nas256/ece3400-team13code/pcb/shield.brd

## EAGLE design pcb/shield.brd (2017-11-17)

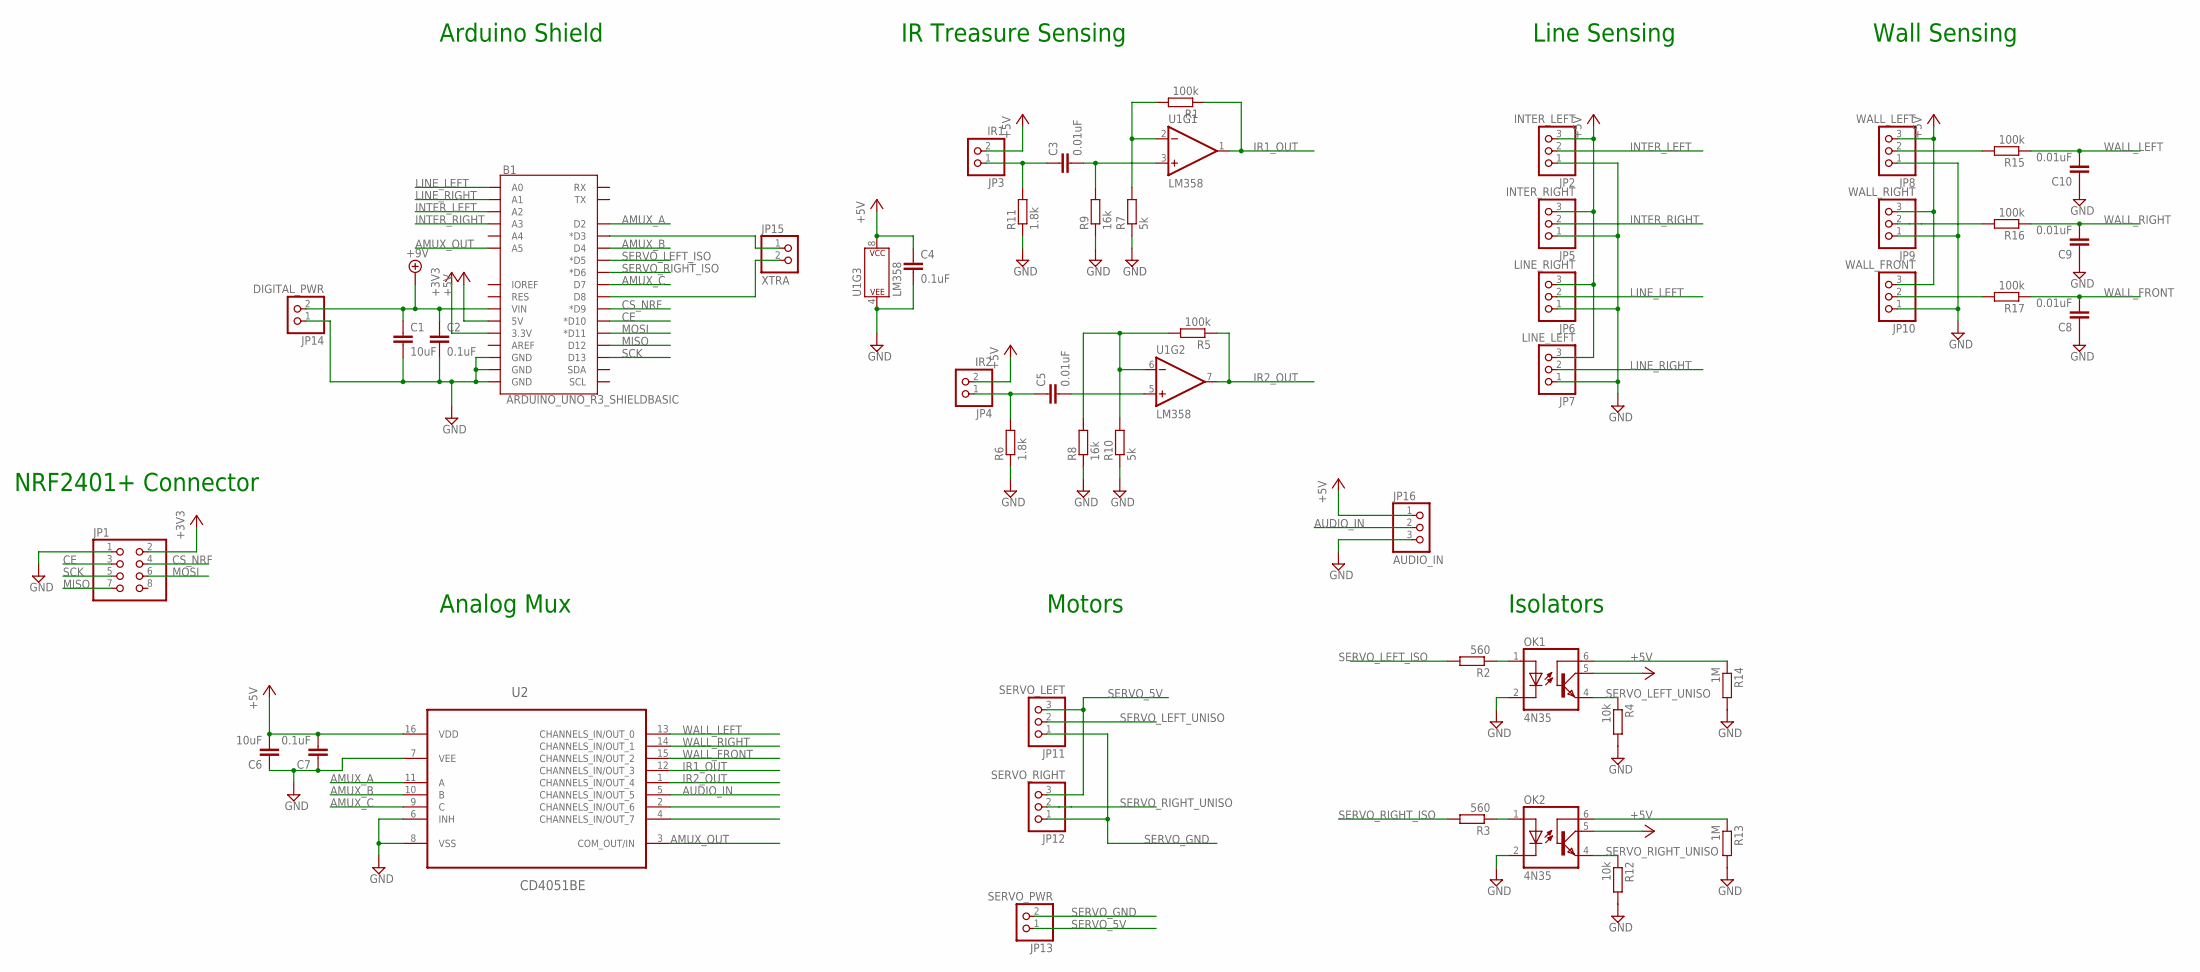
[picture p1: schematic shield.sch]

Parts:
B1: ARDUINO_UNO_R3_SHIELDBASIC; UNO_R3_SHIELD
C1, C6: 10uF; C5B3
C2, C7: 0.1uF; C5B3
C3, C5, C8, C9, C10: 0.01uF; C5B3
C4: 0.1uF; C2.5-2
JP1: PINHD-2X4; 2X04
JP2: INTER_LEFT; 1X03
JP3: IR1; 1X02
JP4: IR2; 1X02
JP5: INTER_RIGHT; 1X03
JP6: LINE_RIGHT; 1X03
JP7: LINE_LEFT; 1X03
JP8: WALL_LEFT; 1X03
JP9: WALL_RIGHT; 1X03
JP10: WALL_FRONT; 1X03
JP11: SERVO_LEFT; 1X03
JP12: SERVO_RIGHT; 1X03
JP13: SERVO_PWR; 1X02
JP14: DIGITAL_PWR; 1X02
JP15: XTRA; 1X02
JP16: AUDIO_IN; 1X03
OK1, OK2: 4N35; DIL06
R1, R5, R15, R16, R17: 100k; VMTA55
R2, R3: 560; VMTA55
R4, R12: 10k; VMTA55
R6, R11: 1.8k; VMTA55
R7, R10: 5k; VMTA55
R8, R9: 16k; VMTA55
R13, R14: 1M; VMTA55
U1: LM358; DIP08
U2: CD4051BE; DIP254P762X508-16

Connections:
+3V3: B1.3.3V, JP1.2
+5V: B1.5V, C4.1, C6.2, C7.2, JP2.3, JP3.2, JP4.2, JP5.3, JP6.3, JP7.3, JP8.3, JP9.3, JP10.3, JP16.1, OK1.5 (COL), OK2.5 (COL), U1.8 (P$V+), U2.16 (VDD)
AMUX_A: B1.D2, U2.11 (A)
AMUX_B: B1.D4, U2.10 (B)
AMUX_C: B1.D7, U2.9 (C)
AMUX_OUT: B1.A5, U2.3 (COM_OUT/IN)
AUDIO_IN: JP16.2, U2.5 (CHANNELS_IN/OUT_5)
CE: B1.D10 (*D10), JP1.3
CS_NRF: B1.D9 (*D9), JP1.4
GND: B1.GND@0 (GND), B1.GND@1 (GND), B1.GND@2 (GND), C1.2, C2.2, C4.2, C6.1, C7.1, C8.1, C9.1, C10.1, JP1.1, JP2.1, JP5.1, JP6.1, JP7.1, JP8.1, JP9.1, JP10.1, JP14.1, JP16.3, OK1.2 (C), OK2.2 (C), R4.2, R6.1, R7.1, R8.1, R9.1, R10.1, R11.1, R12.2, R13.2, R14.2, U1.4 (P$V-), U2.6 (INH), U2.7 (VEE), U2.8 (VSS)
INTER_LEFT: B1.A2, JP2.2
INTER_RIGHT: B1.A3, JP5.2
IR1_OUT: R1.1, U1.1 (OUT), U2.12 (CHANNELS_IN/OUT_3)
IR2_OUT: R5.1, U1.7 (OUT), U2.1 (CHANNELS_IN/OUT_4)
LINE_LEFT: B1.A0, JP6.2
LINE_RIGHT: B1.A1, JP7.2
MISO: B1.D12, JP1.7
MOSI: B1.D11 (*D11), JP1.6
unnamed: C3.1, JP3.1, R11.2
unnamed: B1.VIN, C1.1, C2.1, JP14.2
unnamed: C3.2, R9.2, U1.3 (+IN)
unnamed: R1.2, R7.2, U1.2 (-IN)
unnamed: C5.1, JP4.1, R6.2
unnamed: C5.2, U1.5 (+IN)
unnamed: R5.2, R8.2, R10.2, U1.6 (-IN)
unnamed: OK1.6 (BAS), R14.1
unnamed: B1.D3 (*D3), JP15.1
unnamed: OK2.1 (A), R3.1
unnamed: OK1.1 (A), R2.1
unnamed: B1.D8, JP15.2
unnamed: JP8.2, R15.2
unnamed: OK2.6 (BAS), R13.1
unnamed: JP9.2, R16.2
unnamed: JP10.2, R17.2
SCK: B1.D13, JP1.5
SERVO_5V: JP11.3, JP12.3, JP13.1
SERVO_GND: JP11.1, JP12.1, JP13.2
SERVO_LEFT_ISO: B1.D5 (*D5), R2.2
SERVO_LEFT_UNISO: JP11.2, OK1.4 (EMI), R4.1
SERVO_RIGHT_ISO: B1.D6 (*D6), R3.2
SERVO_RIGHT_UNISO: JP12.2, OK2.4 (EMI), R12.1
WALL_FRONT: C8.2, R17.1, U2.15 (CHANNELS_IN/OUT_2)
WALL_LEFT: C10.2, R15.1, U2.13 (CHANNELS_IN/OUT_0)
WALL_RIGHT: C9.2, R16.1, U2.14 (CHANNELS_IN/OUT_1)

Notes on the sheet:
IR Treasure Sensing
Line Sensing
Wall Sensing
Arduino Shield
Analog Mux
Motors
Isolators
NRF2401+ Connector

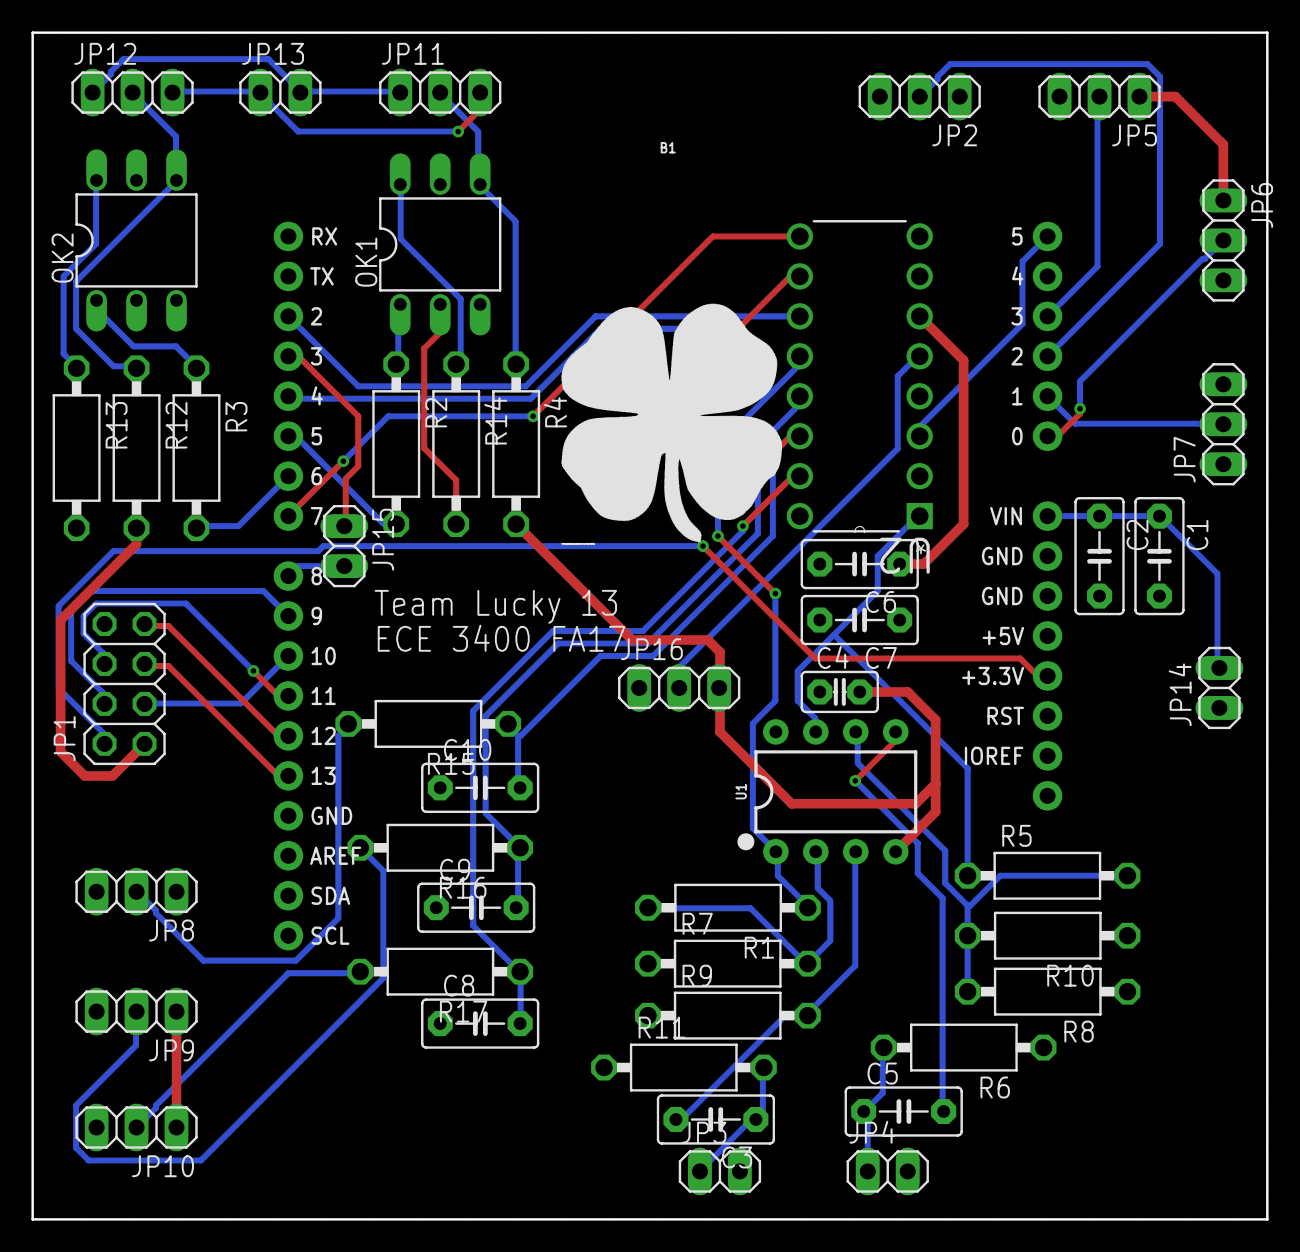
[picture p2: board shield.brd from above]

Board: 2 copper layers, 78.5 x 75.4 mm, 48 parts (0 on the bottom side), 44 nets.
