nas256/ece3400-team13code/Merged_RF_SPI/Merged_RF_SPI.ino

/*
 Copyright (C) 2011 J. Coliz <maniacbug@ymail.com>

 This program is free software; you can redistribute it and/or
 modify it under the terms of the GNU General Public License
 version 2 as published by the Free Software Foundation.
 */

/**
 * Example for Getting Started with nRF24L01+ radios.
 *
 * This is an example of how to use the RF24 class.  Write this sketch to two
 * different nodes.  Put one of the nodes into 'transmit' mode by connecting
 * with the serial monitor and sending a 'T'.  The ping node sends the current
 * time to the pong node, which responds by sending the value back.  The ping
 * node can then see how long the whole cycle took.
 */

#include <SPI.h>
#include "nRF24L01.h"
#include "RF24.h"
#include "printf.h"

//
// Hardware configuration
//

// Set up nRF24L01 radio on SPI bus plus pins 9 & 10

RF24 radio(9,10);

//
// Topology
//

// Radio pipe addresses for the 2 nodes to communicate.
const uint64_t pipes[2] = { 0x000000002CLL, 0x000000002DLL };

//
// Role management
//
// Set up role.  This sketch uses the same software for all the nodes
// in this system.  Doing so greatly simplifies testing.
//

// The various roles supported by this sketch
typedef enum { role_ping_out = 1, role_pong_back } role_e;

// The debug-friendly names of those roles
const char* role_friendly_name[] = { "invalid", "Ping out", "Pong back"};

// The role of the current running sketch
role_e role = role_pong_back;

#define X_SIZE 5
#define Y_SIZE 4

//same x and y bits
//2nd: current location
//3r: already been there
struct grid{
     char traversed;
     char current_location;
};
typedef struct grid grid;

unsigned char x_coord = 0;
unsigned char y_coord = 0;
int turn = 0;
unsigned int maze [5][4];

void setup(void)
{
  int i = 0;
  int j = 0;
  for (; i < 5; i++) {
    for (; j < 4; j++) {
      maze[i][j] = i << 13 | j << 11;
    }
  }
  //
  // Print preamble
  //

  Serial.begin(57600);
  printf_begin();
  printf("\n\rRF24/examples/GettingStarted/\n\r");
  printf("ROLE: %s\n\r",role_friendly_name[role]);
  printf("*** PRESS 'T' to begin transmitting to the other node\n\r");
  pinMode(7,OUTPUT);
  SPI.begin();

  //
  // Setup and configure rf radio
  //

  radio.begin();

  // optionally, increase the delay between retries & # of retries
  radio.setRetries(15,15);
  radio.setAutoAck(true);
  // set the channel
  radio.setChannel(0x50);
  // set the power
  // RF24_PA_MIN=-18dBm, RF24_PA_LOW=-12dBm, RF24_PA_MED=-6dBM, and RF24_PA_HIGH=0dBm.
  radio.setPALevel(RF24_PA_MIN);
  //RF24_250KBPS for 250kbs, RF24_1MBPS for 1Mbps, or RF24_2MBPS for 2Mbps
  radio.setDataRate(RF24_250KBPS);

  // optionally, reduce the payload size.  seems to
  // improve reliability
  //radio.setPayloadSize(8);

  //
  // Open pipes to other nodes for communication
  //

  // This simple sketch opens two pipes for these two nodes to communicate
  // back and forth.
  // Open 'our' pipe for writing
  // Open the 'other' pipe for reading, in position #1 (we can have up to 5 pipes open for reading)

  if ( role == role_ping_out )
  {
    radio.openWritingPipe(pipes[0]);
    radio.openReadingPipe(1,pipes[1]);
  }
  else
  {
    radio.openWritingPipe(pipes[1]);
    radio.openReadingPipe(1,pipes[0]);
  }

  //
  // Start listening
  //

  radio.startListening();

  //
  // Dump the configuration of the rf unit for debugging
  //

  radio.printDetails();
}







void loop(void)
{
  //
  // Ping out role.  Repeatedly send the current time
  //

  if (role == role_ping_out)
  {
    
    // First, stop listening so we can talk.
    radio.stopListening();

    unsigned int new_data;
    // Pack the bits in this pattern
    // x_coord | y_coord | data
    // 3 bits  | 3 bits  | 2 bits
    // This scheme supports a maze up to 8 x 8
    
    unsigned char traverse = 1;
    unsigned char current = 1;
    if (turn == 0) x_coord++;
    if (turn == 1) x_coord--;
    if (x_coord > X_SIZE){ 
      turn = 1;
      y_coord++;
      x_coord--;
    }
    if (x_coord < 0) {
      turn = 0;
      y_coord++;
      x_coord++;
    }
    if (y_coord > Y_SIZE) y_coord = 0;
    
    // Use bit shifting to pack the bits
    // For deployment with a robot, something like this should be factored out into
    // a function, along with the code to unpack the bits
    new_data = x_coord << 13 | y_coord << 11 | traverse << 2 | current << 1;
    
    // For the test case of (5, 5, 3) the byte shoud look like: 10010011
    // In decimal this is 147
    
    // Take the time, and send it.  This will block until complete
    printf("Now sending new map data\n");
    bool ok = radio.write( &new_data, sizeof(new_data) );
    
    if (ok)
      printf("ok...");
    else
      printf("failed.\n\r");


    if (ok)
      printf("ok...");
    else
      printf("failed.\n\r");

    // Now, continue listening
    radio.startListening();

    // Wait here until we get a response, or timeout (250ms)
    unsigned long started_waiting_at = millis();
    bool timeout = false;
    while ( ! radio.available() && ! timeout )
      if (millis() - started_waiting_at > 200 )
        timeout = true;

    // Describe the results
    if ( timeout )
    {
      printf("Failed, response timed out.\n\r");
    }
    else
    {
      // Grab the response, compare, and send to debugging spew
    unsigned int got_data;
    bool done = false;
    while (!done)
    {
      // Fetch the payload, and see if this was the last one.
      done = radio.read( &got_data, sizeof(got_data) );
    
      // Spew it
      // Print the received data as a decimal
      printf("Got payload %u...",got_data);
    
      // Delay just a little bit to let the other unit
      // make the transition to receiver
      delay(20);
    
    }
    }

    // Try again 1s later
    delay(1000);
  }

  //
  // Pong back role.  Receive each packet, dump it out, and send it back
  //

  if ( role == role_pong_back )
  {
    // if there is data ready
    if ( radio.available() )
    {
      // Dump the payloads until we've gotten everything
    unsigned int got_data;
    bool done = false;
    while (!done)
    {
      // Fetch the payload, and see if this was the last one.
      done = radio.read( &got_data, sizeof(got_data) );
    
      // Spew it
      // Print the received data as a decimal
      printf("Got payload %u...",got_data);
    
      // Delay just a little bit to let the other unit
      // make the transition to receiver
      delay(20);
    
    } 

      // First, stop listening so we can talk
      radio.stopListening();
    SPI.beginTransaction(SPISettings(1000000, MSBFIRST, SPI_MODE0)); //10MHz

//    for (uint16_t x = 0; x < X_SIZE; x++){
//    for (uint16_t y = 0; y < Y_SIZE; y++){
      uint16_t result = got_data;
      unsigned char got_x = got_data >> 13;
      unsigned char got_y = (got_data >> 11) && 3;
      maze[got_x][got_y] = got_data;
       
      // Write result out
      digitalWrite(7, LOW);
      SPI.transfer16(result);
      digitalWrite(7, HIGH);
//    }
//  }
  
  SPI.endTransaction();
      // Send the final one back.
      radio.write( &got_data, sizeof(got_data) );
      printf("Sent response.\n\r");

      // Now, resume listening so we catch the next packets.
      radio.startListening();
    }
  }

  //
  // Change roles
  //

  if ( Serial.available() )
  {
    char c = toupper(Serial.read());
    if ( c == 'T' && role == role_pong_back )
    {
      printf("*** CHANGING TO TRANSMIT ROLE -- PRESS 'R' TO SWITCH BACK\n\r");

      // Become the primary transmitter (ping out)
      role = role_ping_out;
      radio.openWritingPipe(pipes[0]);
      radio.openReadingPipe(1,pipes[1]);
    }
    else if ( c == 'R' && role == role_ping_out )
    {
      printf("*** CHANGING TO RECEIVE ROLE -- PRESS 'T' TO SWITCH BACK\n\r");

      // Become the primary receiver (pong back)
      role = role_pong_back;
      radio.openWritingPipe(pipes[1]);
      radio.openReadingPipe(1,pipes[0]);
    }
  }
}
// vim:cin:ai:sts=2 sw=2 ft=cpp
