nas256/ece3400-team13code/verilog/vga_team/AUDIO.v

`define ONE_SEC 25000000

module AUDIO(
  CLOCK_50,
  ENABLE,
  GPIO_1_D
);
   
	input  CLOCK_50;
	input  ENABLE;
	
	output [7:0] GPIO_1_D;

   reg [7:0] sin_table [0:1023];
    
	integer i;
	integer tone_counter;
	integer tone_duration;
	integer freq1;
	integer freq2;
	integer freq3;
   
	reg [7:0] data_out; 
	 
	assign GPIO_1_D[7:0] = data_out;
	 
    // Initialize the sine rom with samples. 
    initial begin
	   sin_table[0] = 40;
	   sin_table[1] = 40;
	   sin_table[2] = 40;
		sin_table[3] = 41;
		sin_table[4] = 41;
		sin_table[5] = 41;
		sin_table[6] = 41;
		sin_table[7] = 42;
		sin_table[8] = 42;
		sin_table[9] = 42;
		sin_table[10] = 42;
		sin_table[11] = 43;
		sin_table[12] = 43;
		sin_table[13] = 43;
		sin_table[14] = 43;
		sin_table[15] = 44;
		sin_table[16] = 44;
		sin_table[17] = 44;
		sin_table[18] = 44;
		sin_table[19] = 45;
		sin_table[20] = 45;
		sin_table[21] = 45;
		sin_table[22] = 45;
		sin_table[23] = 45;
		sin_table[24] = 46;
		sin_table[25] = 46;
		sin_table[26] = 46;
		sin_table[27] = 46;
		sin_table[28] = 47;
		sin_table[29] = 47;
		sin_table[30] = 47;
		sin_table[31] = 47;
		sin_table[32] = 48;
		sin_table[33] = 48;
		sin_table[34] = 48;
		sin_table[35] = 48;
		sin_table[36] = 49;
		sin_table[37] = 49;
		sin_table[38] = 49;
		sin_table[39] = 49;
		sin_table[40] = 49;
		sin_table[41] = 50;
		sin_table[42] = 50;
		sin_table[43] = 50;
		sin_table[44] = 50;
		sin_table[45] = 51;
		sin_table[46] = 51;
		sin_table[47] = 51;
		sin_table[48] = 51;
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
		sin_table[1022] = 40;
		sin_table[1023] = 40;
    end
	 
	 always@ (posedge(CLOCK_50)) begin
       if ( ENABLE ) begin
		  if (tone_counter == 0) begin
			  if (tone_duration < `ONE_SEC) begin
			     tone_duration <= tone_duration + 1;
				  freq1 <= freq1 + 1;
				  if (freq1 == 74) begin 
					  freq1 <= 0;
					  data_out <= sin_table[i];
					  i <= i+ 1;
					  if(i == 1023) begin
							i <= 0;
					  end
				  end
			  end
			  else begin
			      tone_duration <= 0;
					tone_counter <= tone_counter + 1;
			  end
		  end
		  else if (tone_counter == 1) begin
			  if (tone_duration < `ONE_SEC) begin
				  tone_duration <= tone_duration + 1;
				  freq2 <= freq2 + 1;
				  if (freq2 == 99) begin 
					  freq2 <= 0;
					  data_out <= sin_table[i];
					  i <= i+ 1;
					  if(i == 1023) begin
							i <= 0;
					  end
				  end
			  end
			  else begin
			      tone_duration <= 0;
					tone_counter <= tone_counter + 1;
			  end
		  end
		  else begin
			  if (tone_duration < `ONE_SEC) begin
				  tone_duration <= tone_duration + 1;
				  freq3 <= freq3 + 1;
				  if (freq3 == 119) begin 
					  freq3 <= 0;
					  data_out <= sin_table[i];
					  i <= i+ 1;
					  if(i == 1023) begin
							i <= 0;
					  end
				  end
			  end
			  else begin
			      tone_duration <= 0;
					tone_counter <= 0;
			  end
		  end
      end
    end
	 
	 endmodule
