nas256/ece3400-team13code/grid_wall_sensor/mapper.h

#ifndef MAPPER_H
#define MAPPER_H


// Define cardinal directions
#define NORTH  0
#define EAST  1
#define SOUTH 2
#define WEST 3
#define DONE 5

// Define grid sizes
#define GRID_SIZE_X 4
#define GRID_SIZE_Y 5

struct xy_pair{
  uint8_t x;
  uint8_t y;
};
typedef struct xy_pair xy_pair;

#include "stack.h"

struct tile{
     //xy_pair xy_pair;
     /*char traversed;
     char walls; // LSB 4 bits (WEST, EAST, NORTH, SOUTH)
     char freq;*/
     uint16_t data;
};
typedef struct tile tile;

// Initialize state variables
tile tile_array[GRID_SIZE_X][GRID_SIZE_Y];
extern uint8_t cur_orientation;

extern xy_pair pos;
extern xy_pair prev_pos;

// Methods
void init_mapper();
void move_to(char x, char y);
void add_IR(char freq, xy_pair xy);

void tile_set_traversed(xy_pair xy);
void tile_set_walls(xy_pair xy, char walls);
void tile_set_ir(xy_pair xy, char freq);
void tile_transmit(xy_pair xy);
void mapper_done();


#endif
