nas256/ece3400-team13code/grid_wall_sensor/wireless1.h

#include "nRF24L01.h"
#include "RF24.h"
#include "printf.h"

extern RF24 radio;

void wireless_setup(uint8_t wr);

bool wireless_send(void * buf, uint16_t buf_size);

bool wireless_read(void * buf, uint16_t rd_length);
