nas256/ece3400-team13code/(commit log)

2017-09-26 Add lab3 verilog template project
    [DE0_NANO.smp_dump.txt]
2017-09-29 Added FFT optical sketch with LED for milestone 2
2017-09-29 Lotsa stuff: recalibrate robot for shorted servo mounts, add verilog code to display a grid based off memory array
    [DE0_NANO.smp_dump.txt]
2017-10-20 Add support for explored, nonexplored, and current location tiles
2017-10-25 arduino code from 10/19 lab section
    tranverse grid in snake motion
2017-11-05 Comment out dfs code, something's wrong with it
    [grid_wall_sensor.ino, mapper.ino, stack.ino]
2017-11-05 not working version of done signal
    [grid_wall_sensor.ino, mapper.ino]
2017-11-17 Add pcb
    [shield.brd, shield.sch]
2017-11-17 IR is currently commented out, and changed wireless to uint16
2017-11-17 Add wall and done functionality to verilog, simulate with arduino :)
2017-11-18 Make grid wall sensor run on bot
2017-11-18 Verilog: flip screen to match robot view
    [DE0_NANO.v, MAZE_MAPPER.v]
2017-11-19 Verilog: invert y (todo: include enough bits to use IR)
    [MAZE_MAPPER.v]
2017-11-20 Fix coordinate system on bot to align with actual competition
    [mapper.ino]
2017-11-21 IR sensing mostly works, will need to play with amp circuit a bit
2017-12-01 Update pinout to pcb
2017-12-02 If all else fails, revert to this
    [IR.ino, grid_wall_sensor.ino]
